sparkfun/SparkFun_Qwiic_IMU_BMI330/docs/docs/Resources.md

# Resources

For more information about the SparkFun 6DoF IMU Breakout - BMI330 (Qwiic) take a look at the following resources:

* [Schematic](/ref/SparkFun_Qwiic_IMU_BMI330.pdf)
* [KiCad Files](/ref/SparkFun_Qwiic_IMU_BMI330.zip)
* [Board Dimensions](/ref/SparkFun_Qwiic_IMU_BMI330.png)
* [Datasheet](/ref/BMI330.pdf) (BMI330)
* [SparkFun BMI330 Arduino Library](https://github.com/sparkfun/SparkFun_BMI330_Arduino_Library)
* [GitHub Repository](https://github.com/sparkfun/SparkFun_Qwiic_IMU_BMI330)
