sparkfun/SparkFun_Qwiic_IMU_BMI330/Documents/0cf91fa97151b3ddea6ac73275d8f6553add1ca0.png

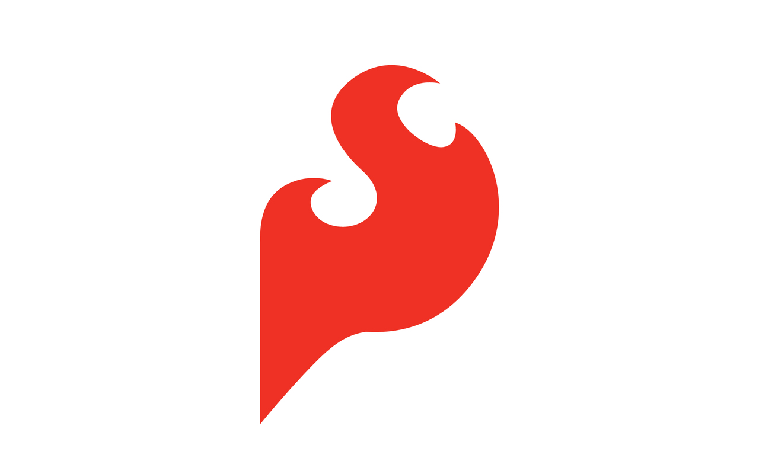
Documents/0cf91fa97151b3ddea6ac73275d8f6553add1ca0.png
