sparkfun/SparkFun_Qwiic_IMU_BMI330/Hardware/SparkFun_Qwiic_IMU_BMI330.kicad_pcb

## KiCad design Hardware/SparkFun_Qwiic_IMU_BMI330.kicad_pcb (2026-08-20)

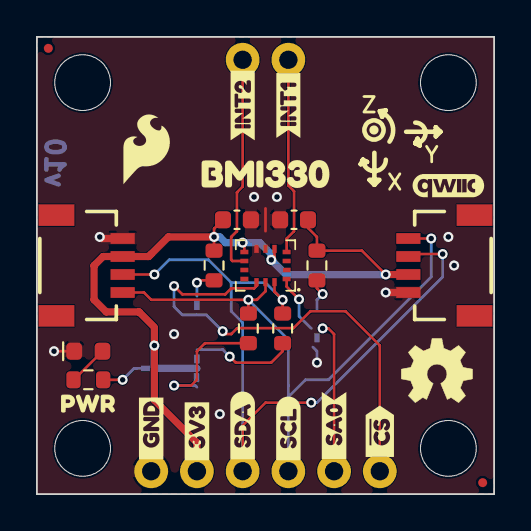
[picture p7: board SparkFun_Qwiic_IMU_BMI330.kicad_pcb from above]

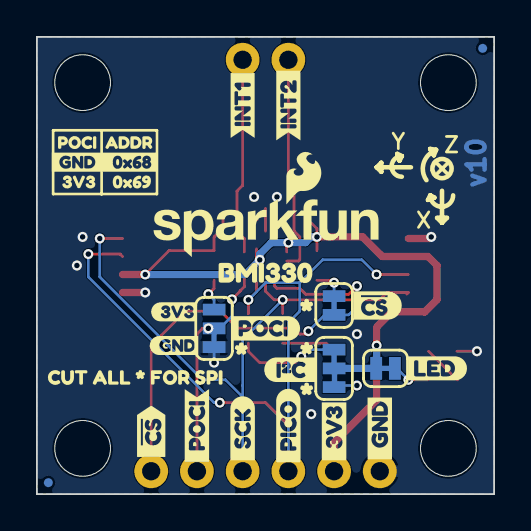
[picture p8: board SparkFun_Qwiic_IMU_BMI330.kicad_pcb from below]

Board: 2 copper layers, 25.4 x 25.4 mm, 60 parts (29 on the bottom side), 14 nets.

Parts:
C3, C4: 0.1uF; C_0603_1608Metric
D1: Red; LED_0603_1608Metric_Red
FID1, FID2, FID3, FID4: Fiducial_0.5mm; Fiducial_0.5mm_Mask1mm
G4: OSHW_Logo; Creative_Commons_License
J1, J2: Qwiic_RA; JST_1x04_P1.0mm_Horizontal_SMD
J3: Conn_01x06; 1x06_P2.54mm
J4: Conn_01x02; 1x02_P2.54mm
JP1: LED; Jumper_2_NC_Trace
JP2: I²C; Jumper_3_NC-2_Trace
JP3: ~{CS}; Jumper_2_NC_Trace
JP4: ADDR; Jumper_3_NC-1_Trace
R1, R2: 10k; R_0603_1608Metric
R3: 4.7k; R_0603_1608Metric
R4, R5: 2.2k; R_0603_1608Metric
Ref**: Val**; OSHW_Logo_4mm
ST1, ST2, ST3, ST4: Standoff
U1: BMI330; ST_LGA-14L_2.5x3.0mm_P0.5mm_4x3
kibuzzard-6A2AF6B9: G***; kibuzzard-6A2AF6B9
kibuzzard-6A2AF6DB: G***; kibuzzard-6A2AF6DB
kibuzzard-6A2C6EC9: G***; kibuzzard-6A2C6EC9
kibuzzard-6A2C6F4B, kibuzzard-6A2C6F4B#2: G***; kibuzzard-6A2C6F4B
kibuzzard-6A2C6F56, kibuzzard-6A2C6F56#2: G***; kibuzzard-6A2C6F56
kibuzzard-6A399BFC: G***; kibuzzard-6A399BFC
kibuzzard-6A399D1E: G***; kibuzzard-6A399D1E
kibuzzard-6A399D08: G***; kibuzzard-6A399D08
kibuzzard-6A399D19: G***; kibuzzard-6A399D19
kibuzzard-6A3997C3, kibuzzard-6A3997C3#2, kibuzzard-6A3997C3#3, kibuzzard-6A3997C3#4: G***; kibuzzard-6A3997C3
kibuzzard-6A34231C: G***; kibuzzard-6A34231C
kibuzzard-6A39953E: G***; kibuzzard-6A39953E
kibuzzard-6A39988E: G***; kibuzzard-6A39988E
kibuzzard-6A39993E: G***; kibuzzard-6A39993E
kibuzzard-6A39994B: G***; kibuzzard-6A39994B
kibuzzard-6A343325: G***; kibuzzard-6A343325
kibuzzard-6A399819: G***; kibuzzard-6A399819
kibuzzard-6A399897: G***; kibuzzard-6A399897
kibuzzard-6A399913: G***; kibuzzard-6A399913
kibuzzard-6A399936: G***; kibuzzard-6A399936
kibuzzard-69FCD097: G***; kibuzzard-69FCD097
kibuzzard-689A66E2: G***; kibuzzard-689A66E2
kibuzzard-689A66E9: G***; kibuzzard-689A66E9
kibuzzard-689A66EE: G***; kibuzzard-689A66EE
kibuzzard-689A642E: G***; kibuzzard-689A642E
kibuzzard-689A6721: G***; kibuzzard-689A6721
kibuzzard-689A6728: G***; kibuzzard-689A6728
kibuzzard-689A6796: G***; kibuzzard-689A6796

Connections:
3.3V: C3.1, C4.1, J1.2, J2.2, J3.2, JP1.2 (B), JP2.2 (B), R1.2, R2.2, U1.5 (VDDIO), U1.8 (VDD)
GND: C3.2, C4.2, D1.1 (K), J1.1, J2.1, J3.1, JP4.1 (A), U1.6 (GND), U1.7 (GND)
INT1: J4.1, U1.4 (INT1)
INT2: J4.2, U1.9 (INT2)
unnamed: D1.2 (A), R3.1
unnamed: JP1.1 (A), R3.2
unnamed: JP2.1 (A), R5.2
unnamed: JP2.3 (C), R4.2
unnamed: JP3.2 (B), R2.1
unnamed: JP4.3 (C), R1.1
SCL: J1.4, J2.4, J3.4, R4.1, U1.13 (SCL)
SDA/PICO: J1.3, J2.3, J3.3, R5.1, U1.14 (SDA)
SDO/POCI: J3.5, JP4.2 (B), U1.1 (SDO)
~CS: J3.6, JP3.1 (A), U1.12 (~CS)
