sparkfun/SparkFun_Qwiic_IMU_BMI330/Hardware/Production/ordering_instructions.txt

Ordering Instructions:
Panel dimensions: 142.70 x 194.50 mm.
Material: TG135
Solder Mask: Red
Silkscreen Color: White
Layers: 2
Finish: HASL Lead-Free
Thickness: 1.6mm
Outer Copper Weight: 1oz
Minimum track width: 0.15mm (6.00mil)
Minimum via drill: 0.30mm (11.81mil)
