sparkfun/SparkFun_Qwiic_IMU_BMI330/(commit log)

2026-06-17 Initial commit of SparkFun Qwiic IMU - BMI330
    Hardware design files, documentation, and README for the
    SparkFun Qwiic IMU - BMI330 breakout.
2026-06-22 Updated designs based on design review
    - Nudged traces and vias
    - Centered PTH
    - Added Silkscreen for I2C/SPI
2026-08-12 Saved in KiCad V10
2026-08-20 Latest PCB Revision
