sparkfun/SparkFun_Qwiic_IMU_BMI330/(notices)

Notices in the files:
parts and their libraries:
Released under the Creative Commons Attribution Share-Alike 4.0 License
https://creativecommons.org/licenses/by-sa/4.0
